juuwaah/UCR-Biodigestor/(commit log)

2026-05-02 added: Prototype using DC12v pump, and flask server to upload datas from ESP32 to website via Railway
2026-05-02 updated railway link
2026-05-07 added a prototype ino proyect
2026-05-07 deleted old files, including secondary prototype of the biogester
2026-05-08 updated thermal sensor criteria
2026-05-27 added notes: Markov Blanket analysis and Dimensional analysis for the loss of pressure in polyetilane tube
2026-06-11 trigger railway deploy
2026-07-06 fix: tighten control loop and improve dashboartd history; -Removed hysteresis dead band -Cap http timeout at 3s -Refresh history graph ecery 30s -Show sin datos aun when db is empty. -Readme.md updat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
    [biogesterv2.ino]
2026-07-06 added: HTML reset button
2026-09-29 Swich to direct drum heater. with single DS18B20, 1 min min switch time, remove pump/water loop; move credentials to secrets.h
